adafruit/Adafruit-Si5351C-8-Channel-TCXO-Clock-Generator-PCB/Adafruit Si5351C 8 Channel TCXO Clock Generator rev B.brd

## EAGLE design Adafruit Si5351C 8 Channel TCXO Clock Generator rev B.brd (2026-11-06)

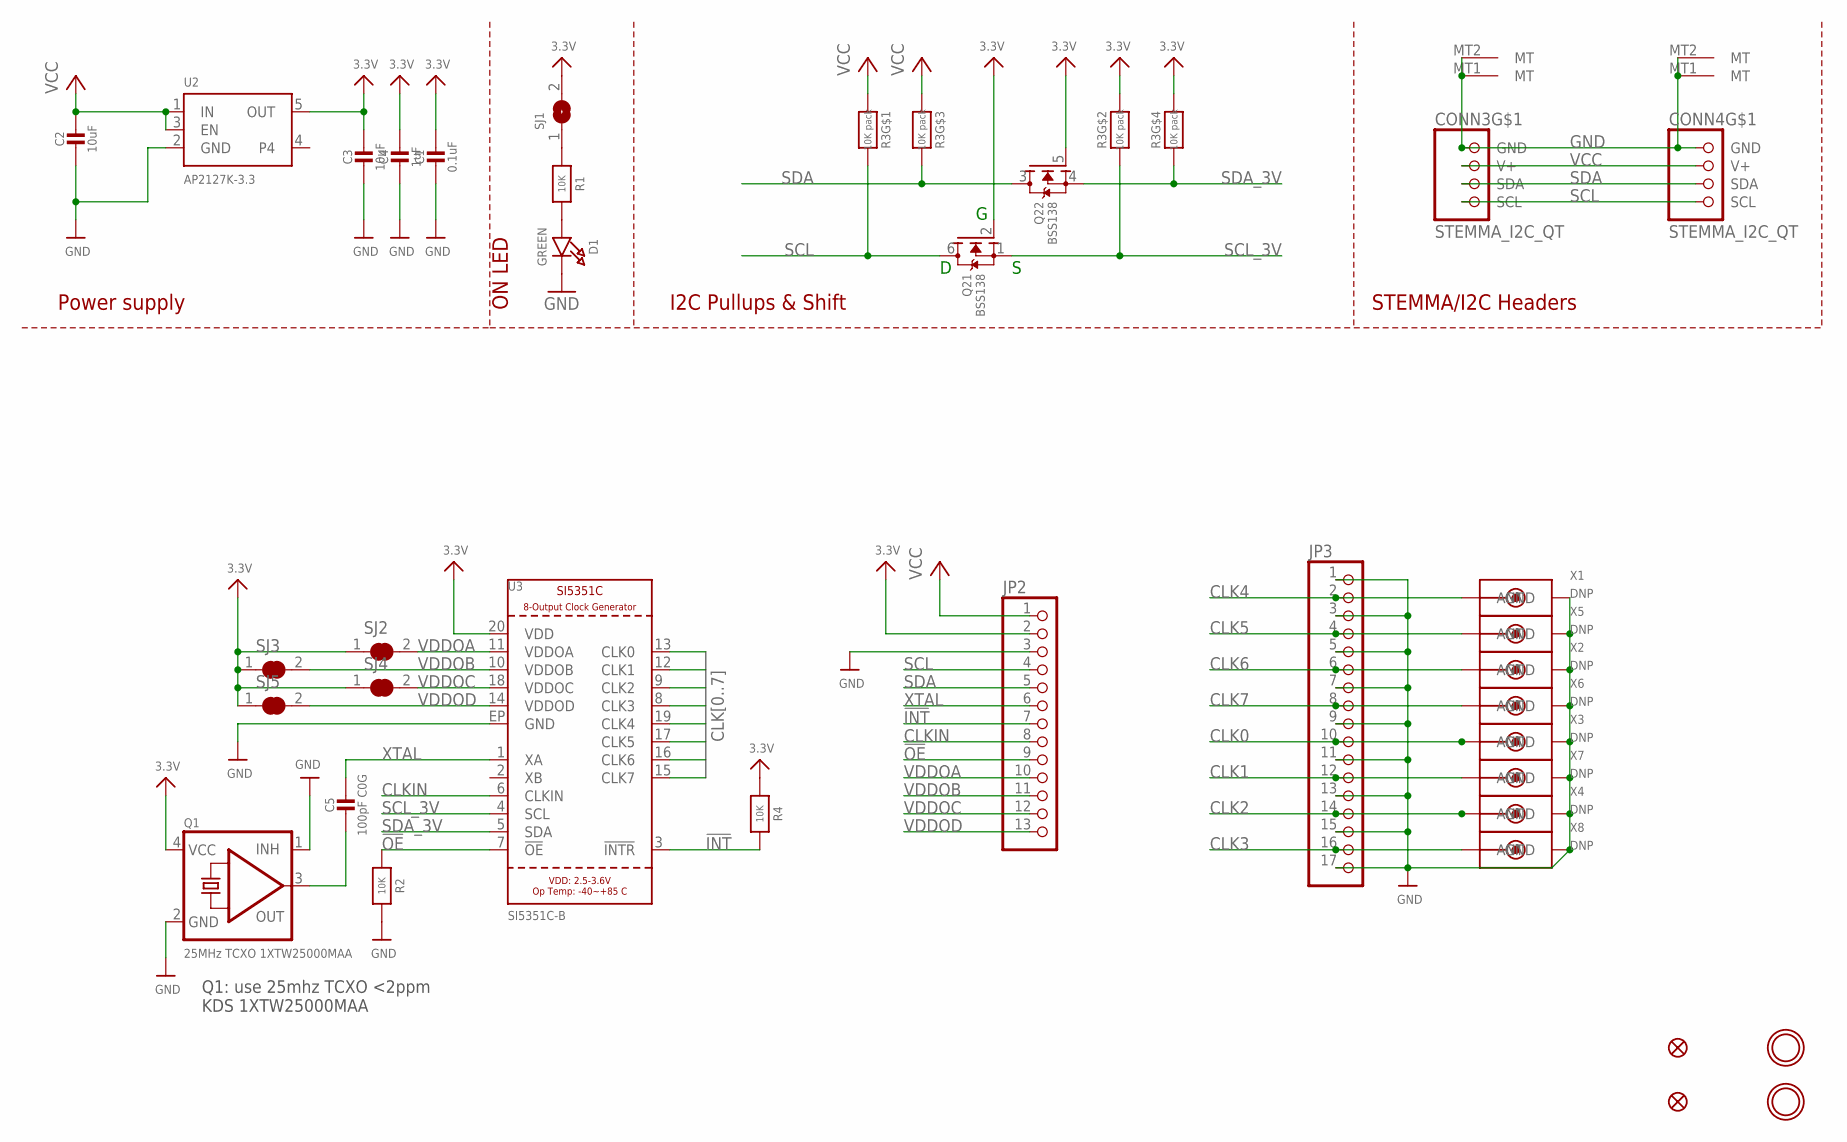
[picture p2: schematic Adafruit Si5351C 8 Channel TCXO Clock Generator rev B.sch]

Parts:
C1: 0.1uF; 0603-NO
C2, C3: 10uF; 0805-NO
C4: 1uF; 0603-NO
C5: 100pF C0G; 0603-NO
CONN3, CONN4: STEMMA_I2C_QT; JST_SH4
D1: GREEN; CHIPLED_0603_NOOUTLINE
FID3, FID4: FIDUCIAL_0.5MM
JP2: HEADER-1X13; 1X13_ROUND_70
JP3: HEADER-1X17; 1X17_ROUND70
Q1: 25MHz TCXO 1XTW25000MAA; OSC_3.2X2.5MM
Q2: BSS138; SOT363
R1, R2, R4: 10K; 0603-NO
R3: 10K pack; RESPACK_4X0603
SJ1: SOLDERJUMPERCLOSED; SOLDERJUMPER_CLOSEDWIRE
SJ2, SJ3, SJ4, SJ5: SOLDERJUMPER_CLOSED; SOLDERJUMPER_CLOSEDWIRE
U2: AP2127K-3.3; SOT23-5
U3: SI5351C-B; QFN20_4X4_0.5_SKY
U$19, U$21: MOUNTINGHOLE2.5; MOUNTINGHOLE_2.5_PLATED
X1, X2, X3, X4, X5, X6, X7, X8: DNP; SMA_EDGELAUNCH

Connections:
3.3V: C1.1, C3.1, C4.1, JP2.2, Q1.4 (VCC), Q2.2 (G), Q2.5 (G), R3.2 (1), R3.4 (1), R4.1, SJ1.2, SJ2.1, SJ3.1, SJ4.1, SJ5.1, U2.5 (OUT), U3.20 (VDD)
!INT: JP2.7, R4.2, U3.3 (!INTR)
!OE: JP2.9, R2.1, U3.7 (!OE)
CLK0: JP3.10, U3.13 (CLK0), X3.P (ANT)
CLK1: JP3.12, U3.12 (CLK1), X7.P (ANT)
CLK2: JP3.14, U3.9 (CLK2), X4.P (ANT)
CLK3: JP3.16, U3.8 (CLK3), X8.P (ANT)
CLK4: JP3.2, U3.19 (CLK4), X1.P (ANT)
CLK5: JP3.4, U3.17 (CLK5), X5.P (ANT)
CLK6: JP3.6, U3.16 (CLK6), X2.P (ANT)
CLK7: JP3.8, U3.15 (CLK7), X6.P (ANT)
CLKIN: JP2.8, U3.6 (CLKIN)
GND: C1.2, C2.2, C3.2, C4.2, CONN3.1 (GND), CONN3.MT1 (MT), CONN3.MT2 (MT), CONN4.1 (GND), CONN4.MT1 (MT), CONN4.MT2 (MT), D1.C, JP2.3, JP3.1, JP3.3, JP3.5, JP3.7, JP3.9, JP3.11, JP3.13, JP3.15, JP3.17, Q1.1 (INH), Q1.2 (GND), R2.2, U2.2 (GND), U3.EP (GND), X1.GND@1 (GND), X1.GND@2 (GND), X1.GND@3 (GND), X1.GND@4 (GND), X2.GND@1 (GND), X2.GND@2 (GND), X2.GND@3 (GND), X2.GND@4 (GND), X3.GND@1 (GND), X3.GND@2 (GND), X3.GND@3 (GND), X3.GND@4 (GND), X4.GND@1 (GND), X4.GND@2 (GND), X4.GND@3 (GND), X4.GND@4 (GND), X5.GND@1 (GND), X5.GND@2 (GND), X5.GND@3 (GND), X5.GND@4 (GND), X6.GND@1 (GND), X6.GND@2 (GND), X6.GND@3 (GND), X6.GND@4 (GND), X7.GND@1 (GND), X7.GND@2 (GND), X7.GND@3 (GND), X7.GND@4 (GND), X8.GND@1 (GND), X8.GND@2 (GND), X8.GND@3 (GND), X8.GND@4 (GND)
unnamed: D1.A, R1.2
unnamed: R1.1, SJ1.1
unnamed: C5.2, Q1.3 (OUT)
SCL: CONN3.4 (SCL), CONN4.4 (SCL), JP2.4, Q2.6 (D), R3.8 (2)
SCL_3V: Q2.1 (S), R3.7 (2), U3.4 (SCL)
SDA: CONN3.3 (SDA), CONN4.3 (SDA), JP2.5, Q2.3 (D), R3.6 (2)
SDA_3V: Q2.4 (S), R3.5 (2), U3.5 (SDA)
VCC: C2.1, CONN3.2 (V+), CONN4.2 (V+), JP2.1, R3.1, R3.3 (1), U2.1 (IN), U2.3 (EN)
VDDOA: JP2.10, SJ2.2, U3.11 (VDDOA)
VDDOB: JP2.11, SJ3.2, U3.10 (VDDOB)
VDDOC: JP2.12, SJ4.2, U3.18 (VDDOC)
VDDOD: JP2.13, SJ5.2, U3.14 (VDDOD)
XTAL: C5.1, JP2.6, U3.1 (XA)

Notes on the sheet:
I2C Pullups & Shift
STEMMA/I2C Headers
ON LED
Power supply
Q1: use 25mhz TCXO <2ppm KDS 1XTW25000MAA

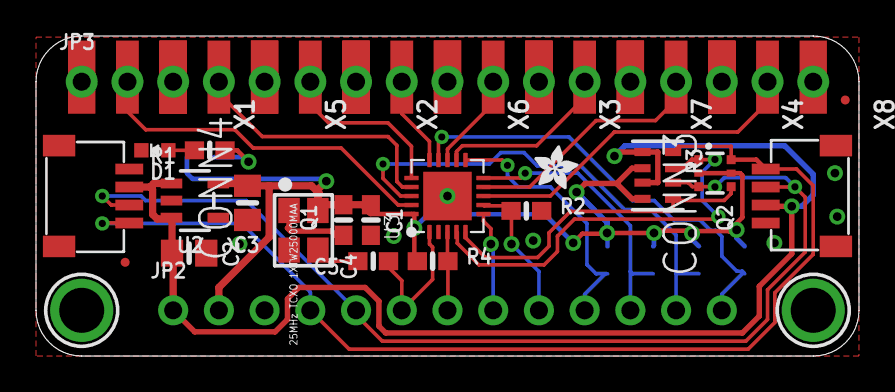
[picture p3: board Adafruit Si5351C 8 Channel TCXO Clock Generator rev B.brd from above]

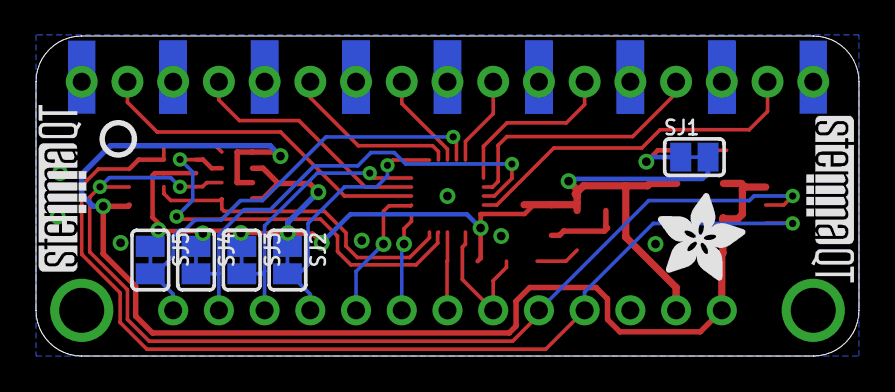
[picture p4: board Adafruit Si5351C 8 Channel TCXO Clock Generator rev B.brd from below]

Board: 2 copper layers, 45.7 x 17.8 mm, 82 parts (17 on the bottom side), 26 nets.

Other parts of the board:
PLABEL0: PLABEL0
PLABEL1: PLABEL1
PLABEL2: PLABEL2
PLABEL3: PLABEL3
PLABEL4: PLABEL4
PLABEL5: PLABEL5
PLABEL11: PLABEL11
PLABEL12: PLABEL12
PLABEL13: PLABEL13
PLABEL14, PLABEL15, PLABEL16, PLABEL17, PLABEL18, PLABEL19, PLABEL20, PLABEL21, PLABEL30: PLABEL14
PLABEL22: PLABEL22
PLABEL23: PLABEL23
PLABEL24: PLABEL24
PLABEL25: PLABEL25
PLABEL26: PLABEL26
PLABEL27: PLABEL27
PLABEL28: PLABEL28
PLABEL29: PLABEL29
PLABEL31: PLABEL31
PLABEL32: PLABEL32
PLABEL34: PLABEL34
PLABEL35: PLABEL35
PLABEL36: PLABEL36
PLABEL37: PLABEL37
PLABEL38: PLABEL38
PLABEL39: PLABEL39
PLABEL40: PLABEL40
PLABEL41: PLABEL41
PLABEL42: PLABEL42
PLABEL43: PLABEL43
PLABEL44: PLABEL44
PLABEL45: PLABEL45
PLABEL46: PLABEL46
PLABEL47: PLABEL47
U$4: ADAFRUIT_5MM
U$9: ADAFRUIT_2.5MM
U$25: PCBFEAT-REV-040
U$30, U$31: STEMMAQT
